staneja1/PI_wt_hold_for_laser_intensity_lock/README.md

# PI with integrator hold for intensity lock
