staneja1/PI_wt_hold_for_laser_intensity_lock/Full PI Board/kicad/3590p-2.stp

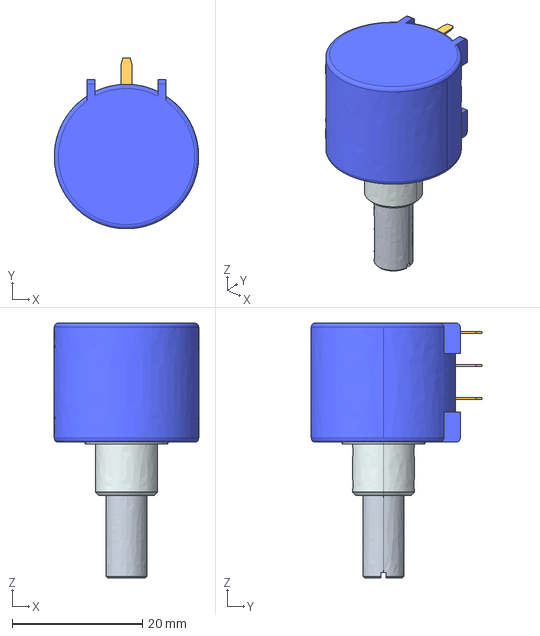
[picture p1: CAD file, 2025-07-23]
Full PI Board/kicad/3590p-2.stp
22.2 x 26.2 x 39.2 mm
