staneja1/PI_wt_hold_for_laser_intensity_lock/Test Board/Test Board/100SPxT2B4M7xE.stp

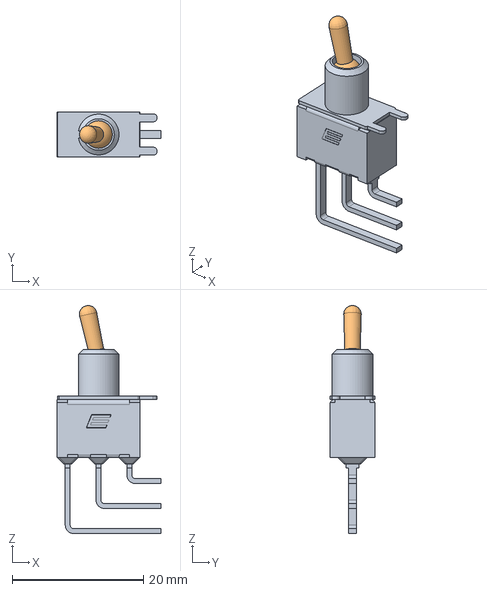
[picture p2: CAD file, 2025-07-23]
Test Board/Test Board/100SPxT2B4M7xE.stp
15.9 x 6.86 x 34.7 mm
