staneja1/PI_wt_hold_for_laser_intensity_lock/Full PI Board/kicad/141_100SPxT2B4M6xE.stp

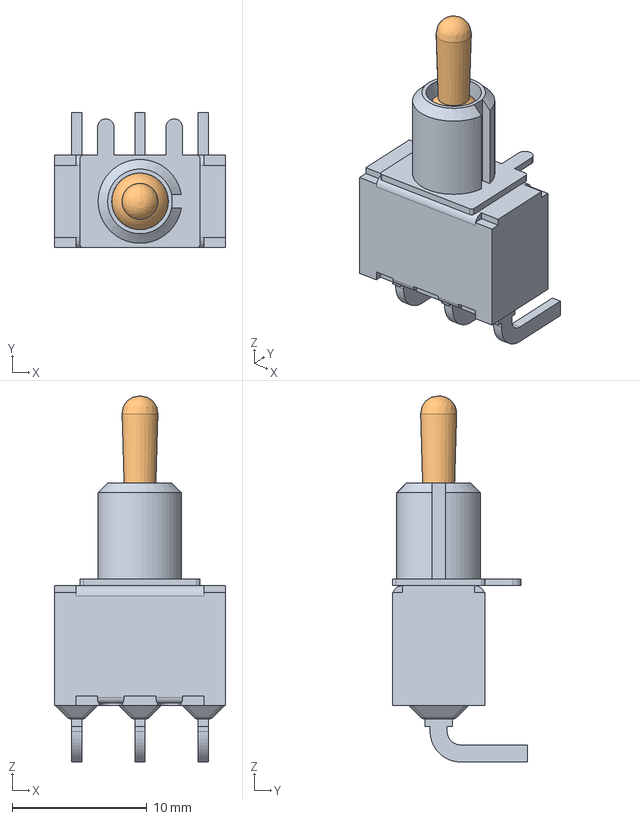
[picture p3: CAD file, 2025-07-23]
Full PI Board/kicad/141_100SPxT2B4M6xE.stp
12.7 x 10.0 x 27.2 mm
