staneja1/PI_wt_hold_for_laser_intensity_lock/Test Board/Test Board/Test Board.kicad_pcb

## KiCad design Test Board/Test Board/Test Board.kicad_pcb (2026-08-11)

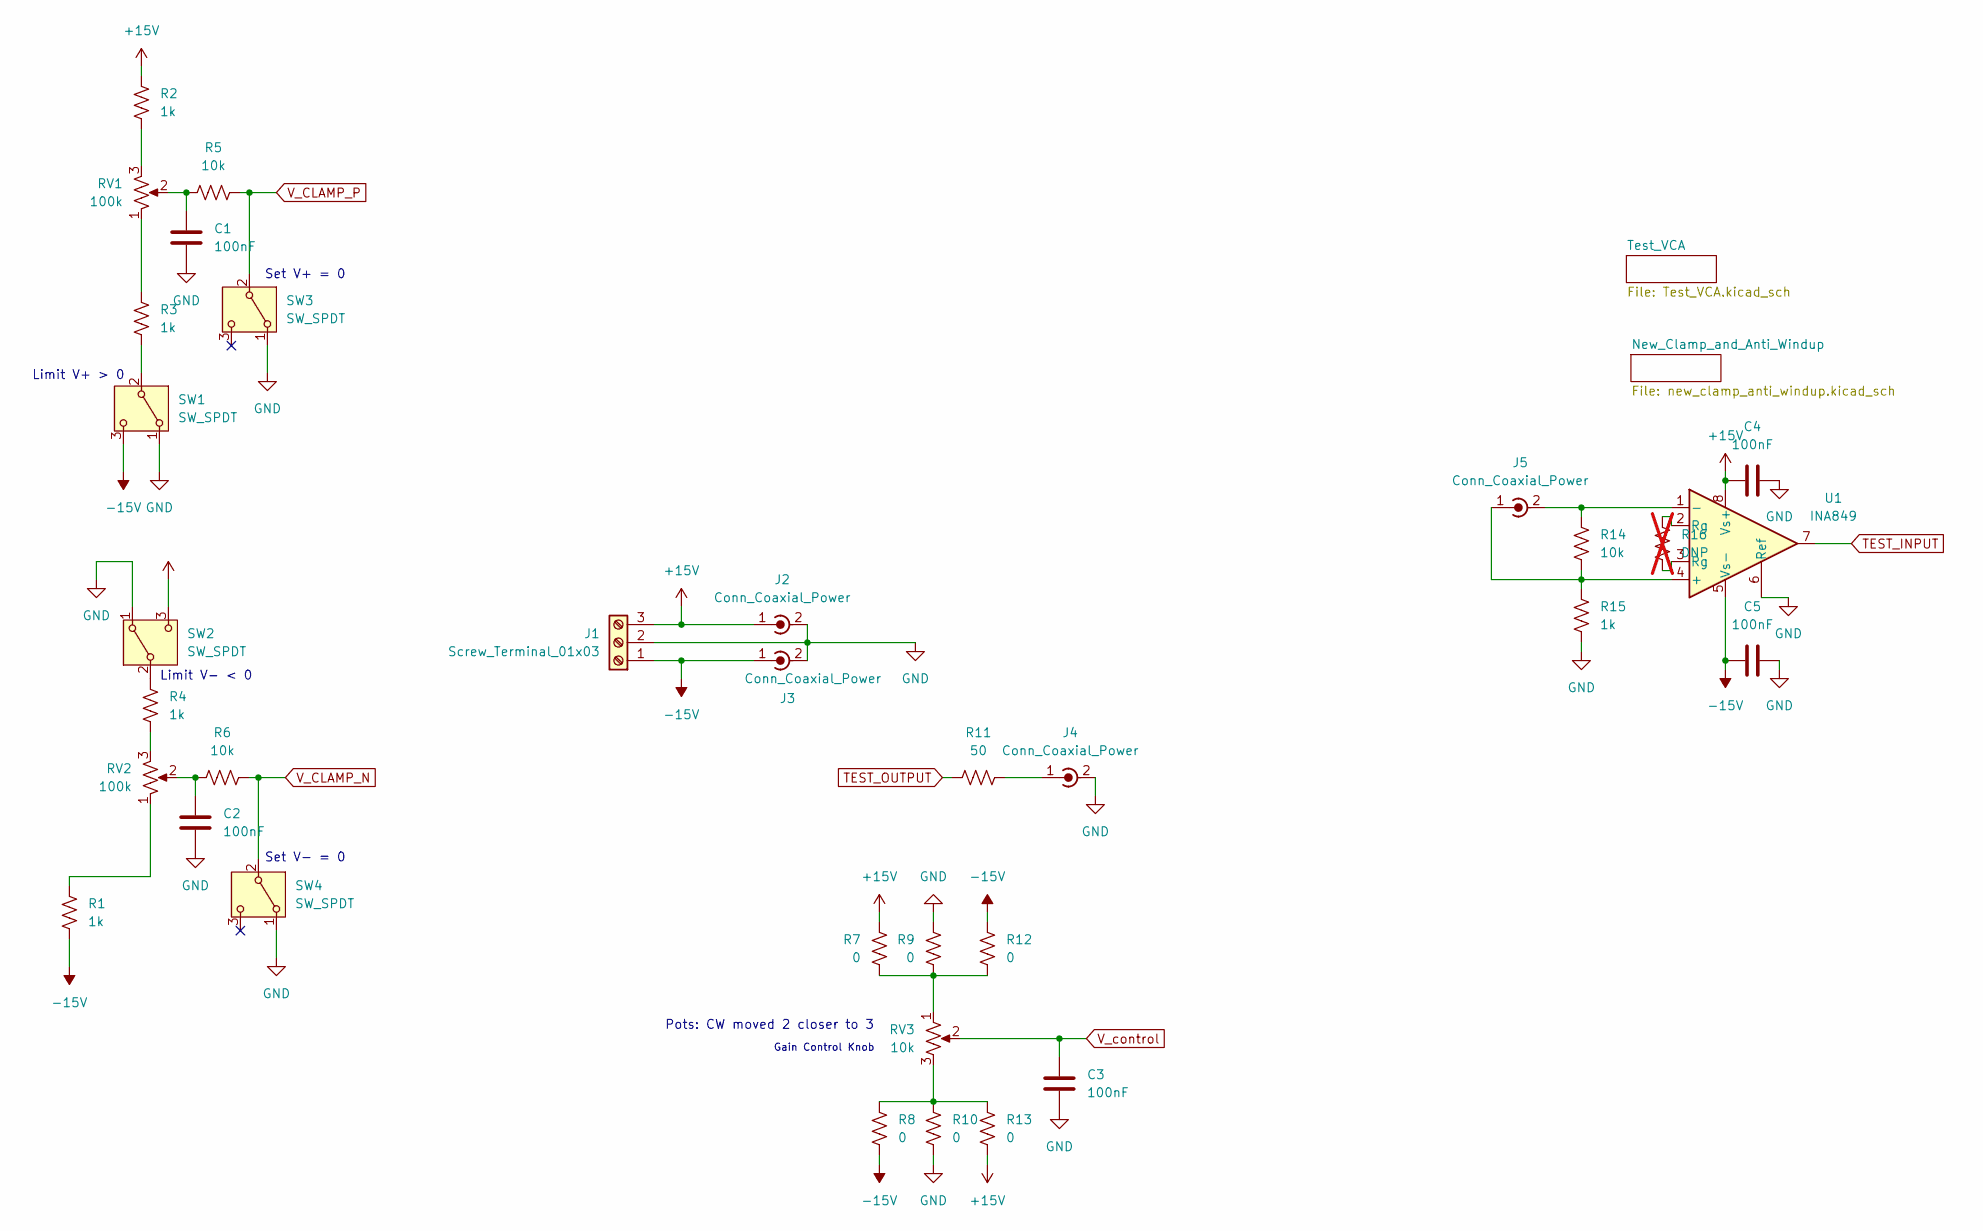
[picture p4: schematic Test Board.kicad_sch]

Parts:
C1, C2, C3, C4, C5: 100nF; C_0805_2012Metric; PARTNO CL21B104KCFNNNE; DIGIKEY 1276-6840-1-ND
J1: Screw_Terminal_01x03; TerminalBlock_4Ucon_1x03_P3.50mm_Horizontal; PARTNO 691214110003; DIGIKEY 732-2748-ND
J2, J3, J4, J5: Conn_Coaxial_Power; SMA_Amphenol_901-143_Horizontal
R1, R2, R3, R4: 1k; R_0805_2012Metric
R5, R6, R14: 10k; R_0805_2012Metric; PARTNO RN73H2ATTD1002B25; DIGIKEY 2019-RN73H2ATTD1002B25CT-ND
R7, R8, R9, R10, R12, R13: 0; R_0805_2012Metric; PARTNO CRCW080550R0FKTA; DIGIKEY 541-CRCW080550R0FKTACT-ND
R11: 50; R_0805_2012Metric; PARTNO CRCW080550R0FKTA; DIGIKEY 541-CRCW080550R0FKTACT-ND
R15: 1k; R_0805_2012Metric; PARTNO RG2012P-102-B-T5; DIGIKEY RG20P1.0KBCT-ND
R16: DNP; R_0805_2012Metric; not fitted
RV1, RV2: 100k; Potentiometer_Bourns_3296W_Vertical; PARTNO PV36W104C01B00; DIGIKEY 118-PV36W104C01B00-ND
RV3: 10k; Bourns Circular Pots; PARTNO 3590P-2-104L; DIGIKEY 3590P-2-104L-ND
SW1, SW2, SW3, SW4: SW_SPDT; TDD DIP Switch; PARTNO TDD01H0SB1R; DIGIKEY CKN10546CT-ND
U1: INA849; SOIC-8_3.9x4.9mm_P1.27mm; PARTNO INA849DR; DIGIKEY 296-INA849DRCT-ND

Connections:
+15V: C4.1, J1.3, J2.1 (In), R2.2, R7.2, R13.2, SW2.3 (C), U1.8 (Vs+); also elsewhere on the board
-15V: C5.1, J1.1, J3.1 (In), R1.1, R8.2, R12.2, SW1.3 (C), U1.5 (Vs-); also elsewhere on the board
GND: C1.1, C2.1, C3.1, C4.2, C5.2, J1.2, J2.2 (Ext), J3.2 (Ext), J4.2 (Ext), R9.2, R10.2, R15.1, SW1.1 (A), SW2.1 (A), SW3.1 (A), SW4.1 (A), U1.6 (Ref); also elsewhere on the board
unnamed: C1.2, R5.1, RV1.2
unnamed: C2.2, R6.1, RV2.2
unnamed: J4.1 (In), R11.2
unnamed: J5.2 (Ext), R14.2, U1.1 (-)
unnamed: J5.1 (In), R14.1, R15.2, U1.4 (+)
unnamed: R1.2, RV2.1
unnamed: R2.1, RV1.3
unnamed: R3.2, RV1.1
unnamed: R4.1, RV2.3
unnamed: R8.1, R10.1, R13.1, RV3.3
unnamed: R7.1, R9.1, R12.1, RV3.1
unnamed: R16.1, U1.3 (Rg)
unnamed: R16.2, U1.2 (Rg)
unnamed: R3.1, SW1.2 (B)
unnamed: R4.2, SW2.2 (B)
TEST_INPUT: U1.7; also elsewhere on the board
TEST_OUTPUT: R11.1; also elsewhere on the board
V_CLAMP_N: R6.2, SW4.2 (B); also elsewhere on the board
V_CLAMP_P: R5.2, SW3.2 (B); also elsewhere on the board
V_control: C3.2, RV3.2; also elsewhere on the board

Notes on the sheet:
Limit V+ > 0
Set V+ = 0
Limit V- < 0
Gain Control Knob
Set V- = 0
Pots: CW moved 2 closer to 3

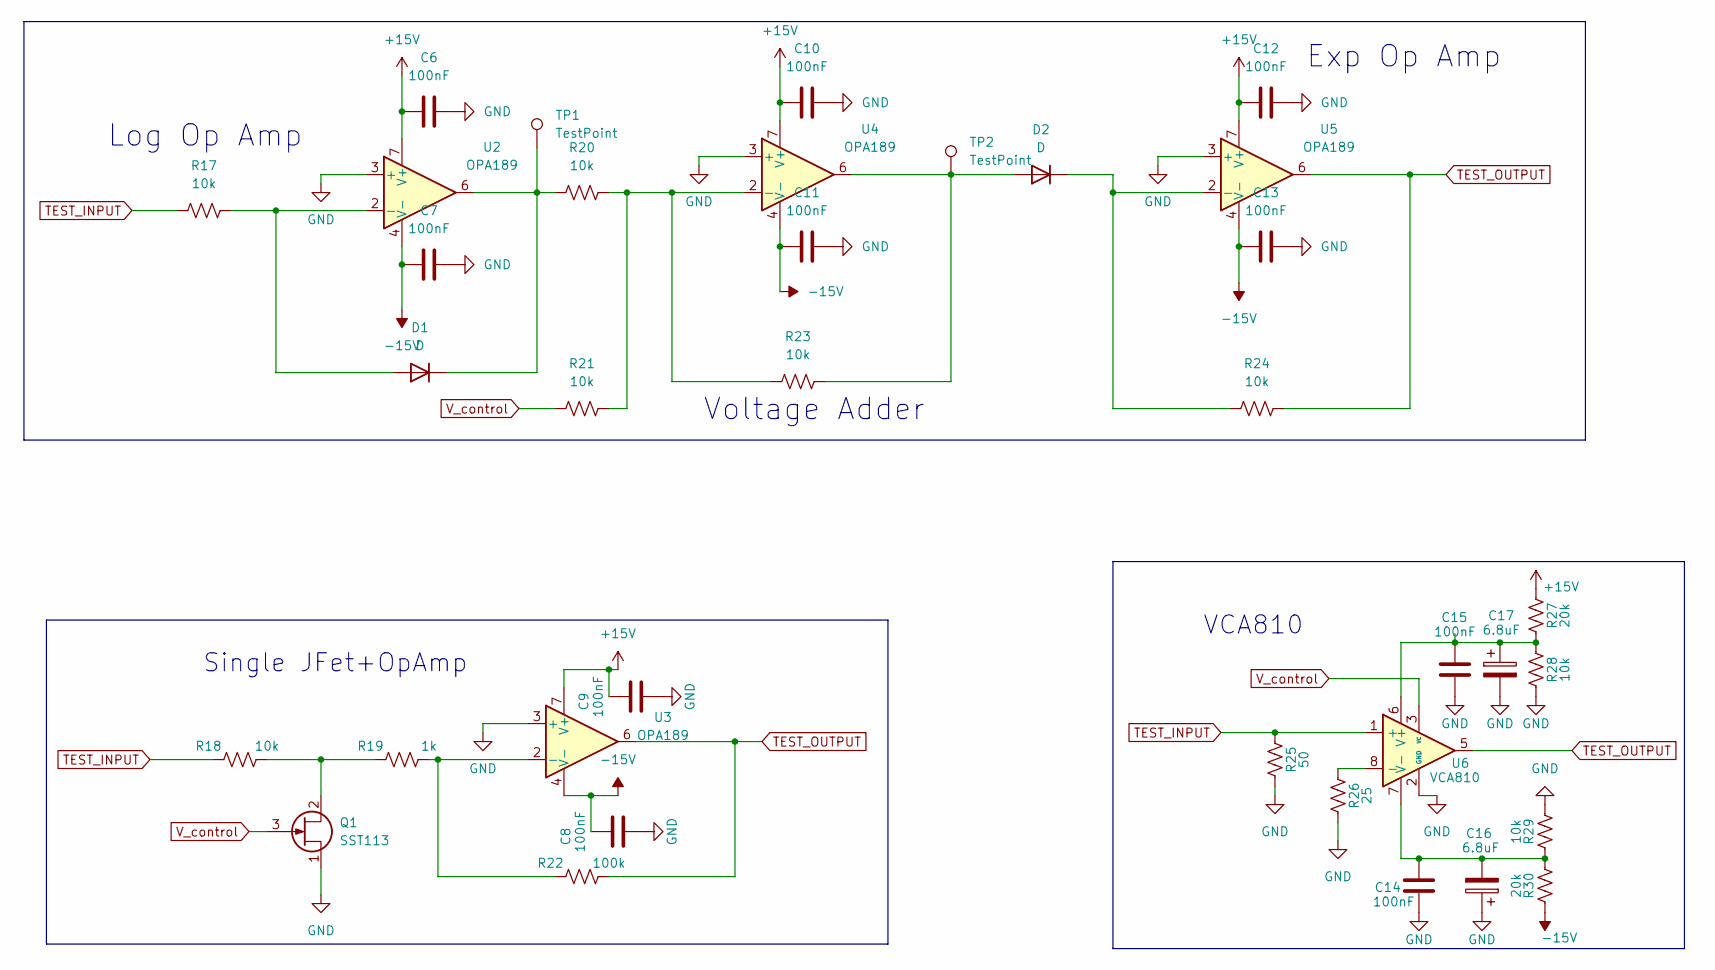
[picture p5: schematic Test_VCA.kicad_sch]

Parts:
C6, C7, C8, C9, C10, C11, C12, C13, C14, C15: 100nF; C_0805_2012Metric; PARTNO CL21B104KCFNNNE; DIGIKEY 1276-6840-1-ND
C16, C17: 6.8uF; C_0805_2012Metric
D1, D2: D; TSOT-23; PARTNO SSTPAD5 SOT-23 3L ROHS; DIGIKEY 4004-SSTPAD5SOT-233LROHSCT-ND
Q1: SST113; SOT-23
R17, R18, R23, R24, R28, R29: 10k; R_0805_2012Metric
R19: 1k; R_0805_2012Metric
R20, R21: 10k; R_0805_2012Metric; PARTNO RN73H2ATTD1002B25; DIGIKEY 2019-RN73H2ATTD1002B25CT-ND
R22: 100k; R_0805_2012Metric
R25: 50; R_0805_2012Metric
R26: 25; R_0805_2012Metric
R27, R30: 20k; R_0805_2012Metric
TP1, TP2: TestPoint; TestPoint_Loop_D2.60mm_Drill1.6mm_Beaded
U2, U3, U4, U5: OPA189; SOIC-8_3.9x4.9mm_P1.27mm; PARTNO OPA189ID; DIGIKEY 296-47522-ND
U6: VCA810; SOIC-8_3.9x4.9mm_P1.27mm

Connections:
+15V: C6.1, C9.1, C10.1, C12.1, R27.1, U2.7 (V+), U3.7 (V+), U4.7 (V+), U5.7 (V+); also elsewhere on the board
-15V: C7.1, C8.1, C11.1, C13.1, R30.1, U2.4 (V-), U3.4 (V-), U4.4 (V-), U5.4 (V-); also elsewhere on the board
GND: C6.2, C7.2, C8.2, C9.2, C10.2, C11.2, C12.2, C13.2, C14.2, C15.2, C16.1, C17.2, Q1.1 (S), R25.2, R26.2, R28.2, R29.2, U2.3 (+), U3.3 (+), U4.3 (+), U5.3 (+), U6.2 (GND); also elsewhere on the board
unnamed: D1.2 (A), R17.2, U2.2 (-)
unnamed: D1.1 (K), R20.1, TP1.1 (1_1), U2.6
unnamed: D2.2 (A), R23.2, TP2.1 (1_1), U4.6
unnamed: D2.1 (K), R24.1, U5.2 (-)
unnamed: Q1.2 (D), R18.2, R19.1
unnamed: R19.2, R22.1, U3.2 (-)
unnamed: R20.2, R21.2, R23.1, U4.2 (-)
unnamed: R26.1, U6.8 (-)
unnamed: C15.1, C17.1, R27.2, R28.1, U6.6 (V+)
unnamed: C14.1, C16.2, R29.1, R30.2, U6.7 (V-)
TEST_INPUT: R17.1, R18.1, R25.1, U6.1 (+); also elsewhere on the board
TEST_OUTPUT: R22.2, R24.2, U3.6, U5.6, U6.5; also elsewhere on the board
V_control: Q1.3 (G), R21.1, U6.3 (VC); also elsewhere on the board

Notes on the sheet:
Exp Op Amp
Voltage Adder
Single JFet+OpAmp
VCA810
Log Op Amp

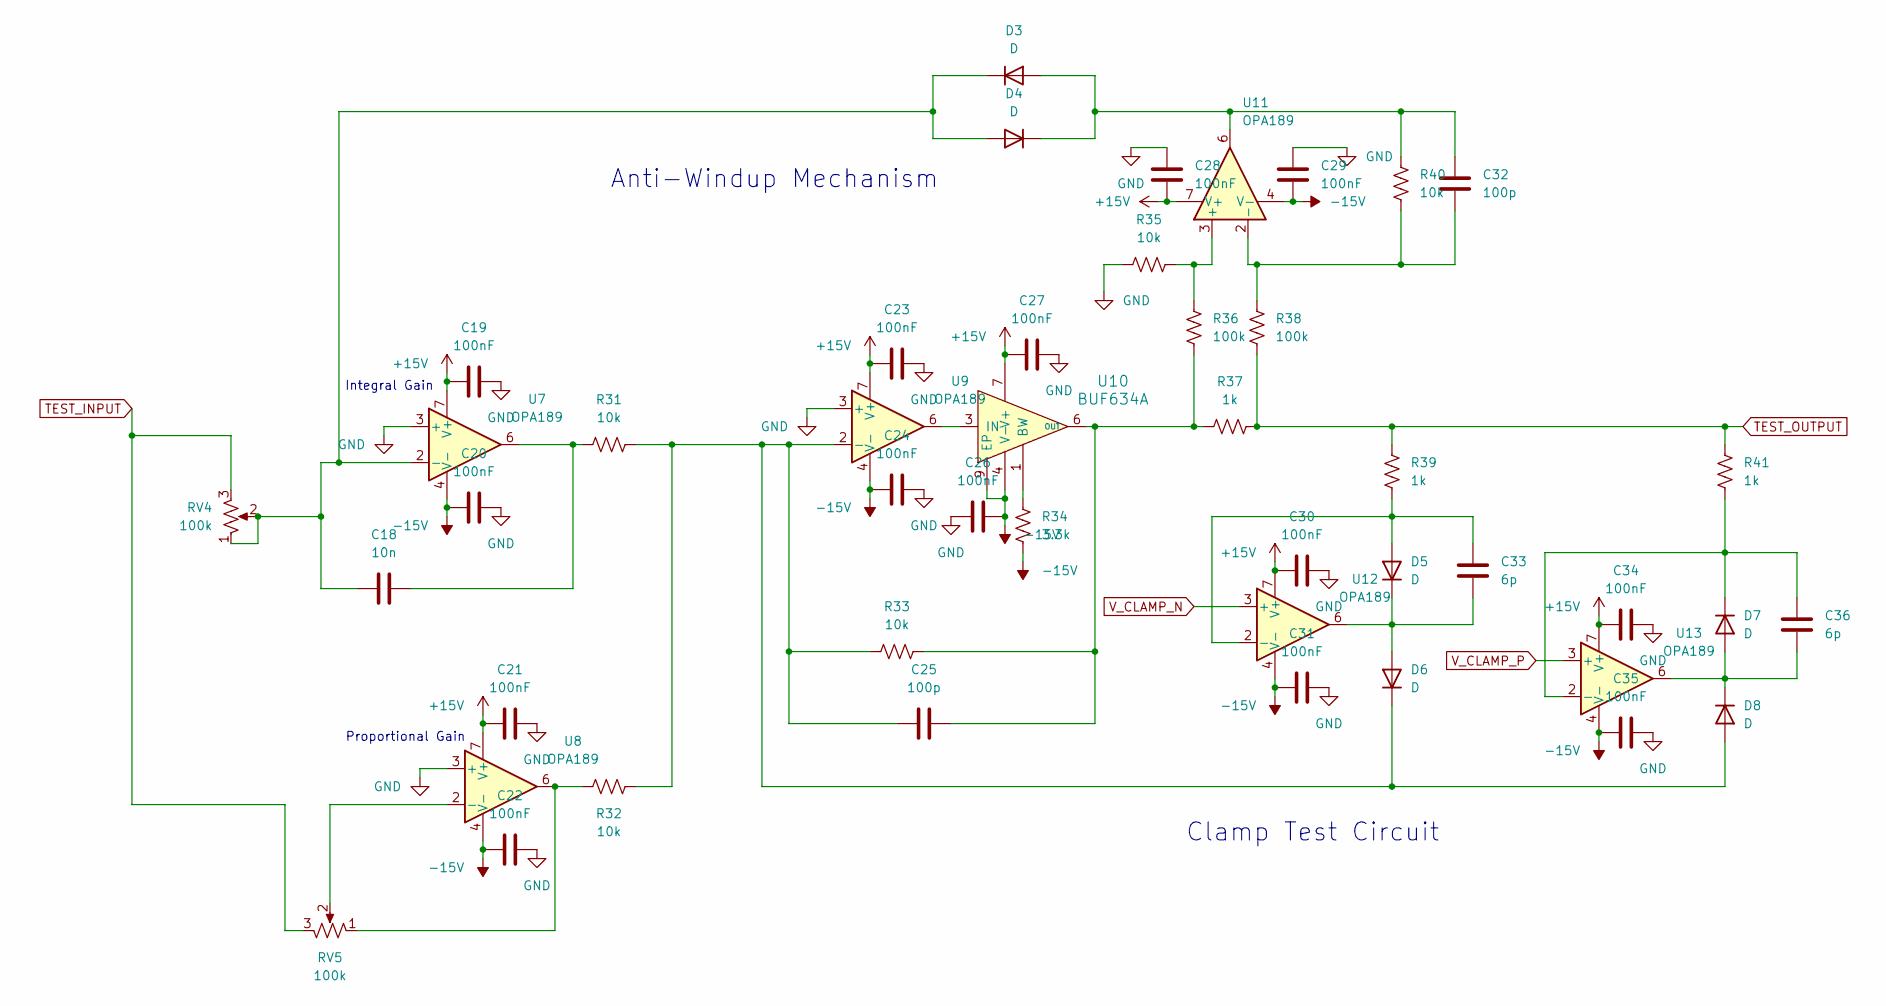
[picture p6: schematic new_clamp_anti_windup.kicad_sch]

Parts:
C18: 10n; C_0805_2012Metric; PARTNO C0805C101J5GACTU; DIGIKEY 399-C0805C101J5GACTUCT-ND
C19, C20, C21, C22, C23, C24, C26, C27, C28, C29, C30, C31, C34, C35: 100nF; C_0805_2012Metric; PARTNO CL21B104KCFNNNE; DIGIKEY 1276-6840-1-ND
C25, C32: 100p; C_0805_2012Metric; PARTNO C0805C101J5GACTU; DIGIKEY 399-C0805C101J5GACTUCT-ND
C33, C36: 6p; C_0805_2012Metric
D3, D4, D5, D6, D7, D8: D; TSOT-23; PARTNO SSTPAD5 SOT-23 3L ROHS; DIGIKEY 4004-SSTPAD5SOT-233LROHSCT-ND
R31, R32, R33, R35, R40: 10k; R_0805_2012Metric; PARTNO RN73H2ATTD1002B25; DIGIKEY 2019-RN73H2ATTD1002B25CT-ND
R34: 3.3k; R_0805_2012Metric; PARTNO RC0805FR-073K3L; DIGIKEY 311-3.30KCRCT-ND
R36, R38: 100k; R_0805_2012Metric; PARTNO RN73H2ATTD1002B25; DIGIKEY 2019-RN73H2ATTD1002B25CT-ND
R37, R39, R41: 1k; R_0805_2012Metric; PARTNO RG2012P-102-B-T5; DIGIKEY RG20P1.0KBCT-ND
RV4, RV5: 100k; Potentiometer_Bourns_3296W_Vertical; PARTNO PV36W104C01B00; DIGIKEY 118-PV36W104C01B00-ND
U7, U8, U9, U11, U12, U13: OPA189; SOIC-8_3.9x4.9mm_P1.27mm; PARTNO OPA189ID; DIGIKEY 296-47522-ND
U10: BUF634A; BUF634AIDDAR; PARTNO BUF634AIDDAR; DIGIKEY 296-BUF634AIDDARCT-ND

Connections:
+15V: C19.1, C21.1, C23.1, C27.1, C28.2, C30.1, C34.1, U7.7 (V+), U8.7 (V+), U9.7 (V+), U10.7 (V+), U11.7 (V+), U12.7 (V+), U13.7 (V+); also elsewhere on the board
-15V: C20.1, C22.1, C24.1, C26.2, C29.1, C31.1, C35.1, R34.1, U7.4 (V-), U8.4 (V-), U9.4 (V-), U10.4 (V-), U10.9 (EP), U11.4 (V-), U12.4 (V-), U13.4 (V-); also elsewhere on the board
GND: C19.2, C20.2, C21.2, C22.2, C23.2, C24.2, C26.1, C27.2, C28.1, C29.2, C30.2, C31.2, C34.2, C35.2, R35.2, U7.3 (+), U8.3 (+), U9.3 (+); also elsewhere on the board
unnamed: C18.1, R31.1, U7.6
unnamed: C32.1, D3.2 (A), D4.1 (K), R40.2, U11.6
unnamed: C18.2, D3.1 (K), D4.2 (A), RV4.1, RV4.2, U7.2 (-)
unnamed: C33.1, D5.2 (A), R39.1, U12.2 (-)
unnamed: C33.2, D5.1 (K), D6.2 (A), U12.6
unnamed: C25.2, D6.1 (K), D8.2 (A), R31.2, R32.2, R33.1, U9.2 (-)
unnamed: C36.2, D7.2 (A), D8.1 (K), U13.6
unnamed: C36.1, D7.1 (K), R41.1, U13.2 (-)
unnamed: R32.1, RV5.1, U8.6
unnamed: RV5.2, U8.2 (-)
unnamed: R34.2, U10.1 (BW)
unnamed: U9.6, U10.3 (IN)
unnamed: C25.1, R33.2, R36.1, R37.2, U10.6 (OUT)
unnamed: R35.1, R36.2, U11.3 (+)
unnamed: C32.2, R38.2, R40.1, U11.2 (-)
TEST_INPUT: RV4.3, RV5.3; also elsewhere on the board
TEST_OUTPUT: R37.1, R38.1, R39.2, R41.2; also elsewhere on the board
V_CLAMP_N: U12.3 (+); also elsewhere on the board
V_CLAMP_P: U13.3 (+); also elsewhere on the board

Notes on the sheet:
Clamp Test Circuit
Proportional Gain
Anti-Windup Mechanism
Integral Gain

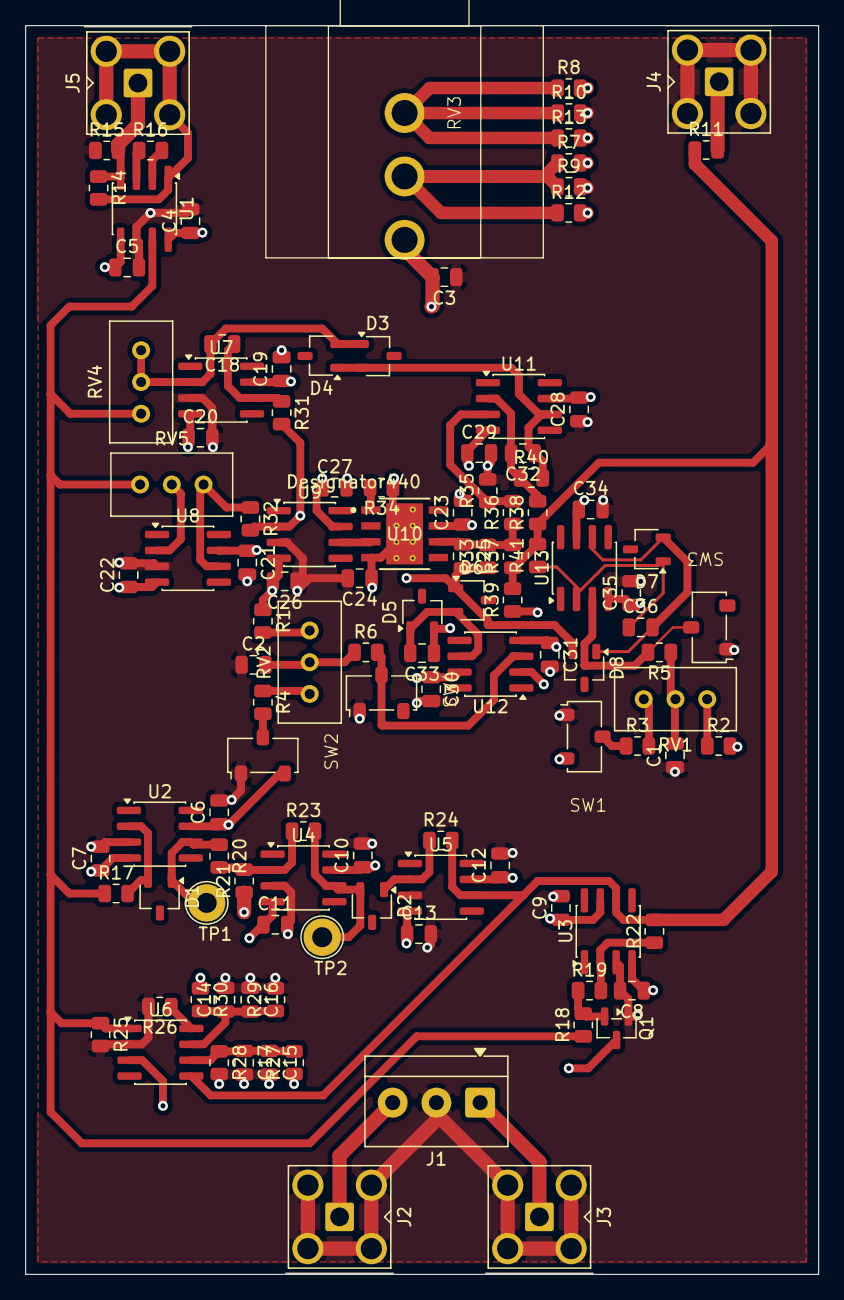
[picture p7: board Test Board.kicad_pcb from above]

Board: 4 copper layers, 63.5 x 100.0 mm, 115 parts (0 on the bottom side), 48 nets.
