staneja1/PI_wt_hold_for_laser_intensity_lock/Full PI Board/kicad/intensity_pi.kicad_pcb

## KiCad design Full PI Board/kicad/intensity_pi.kicad_pcb (2026-08-06)

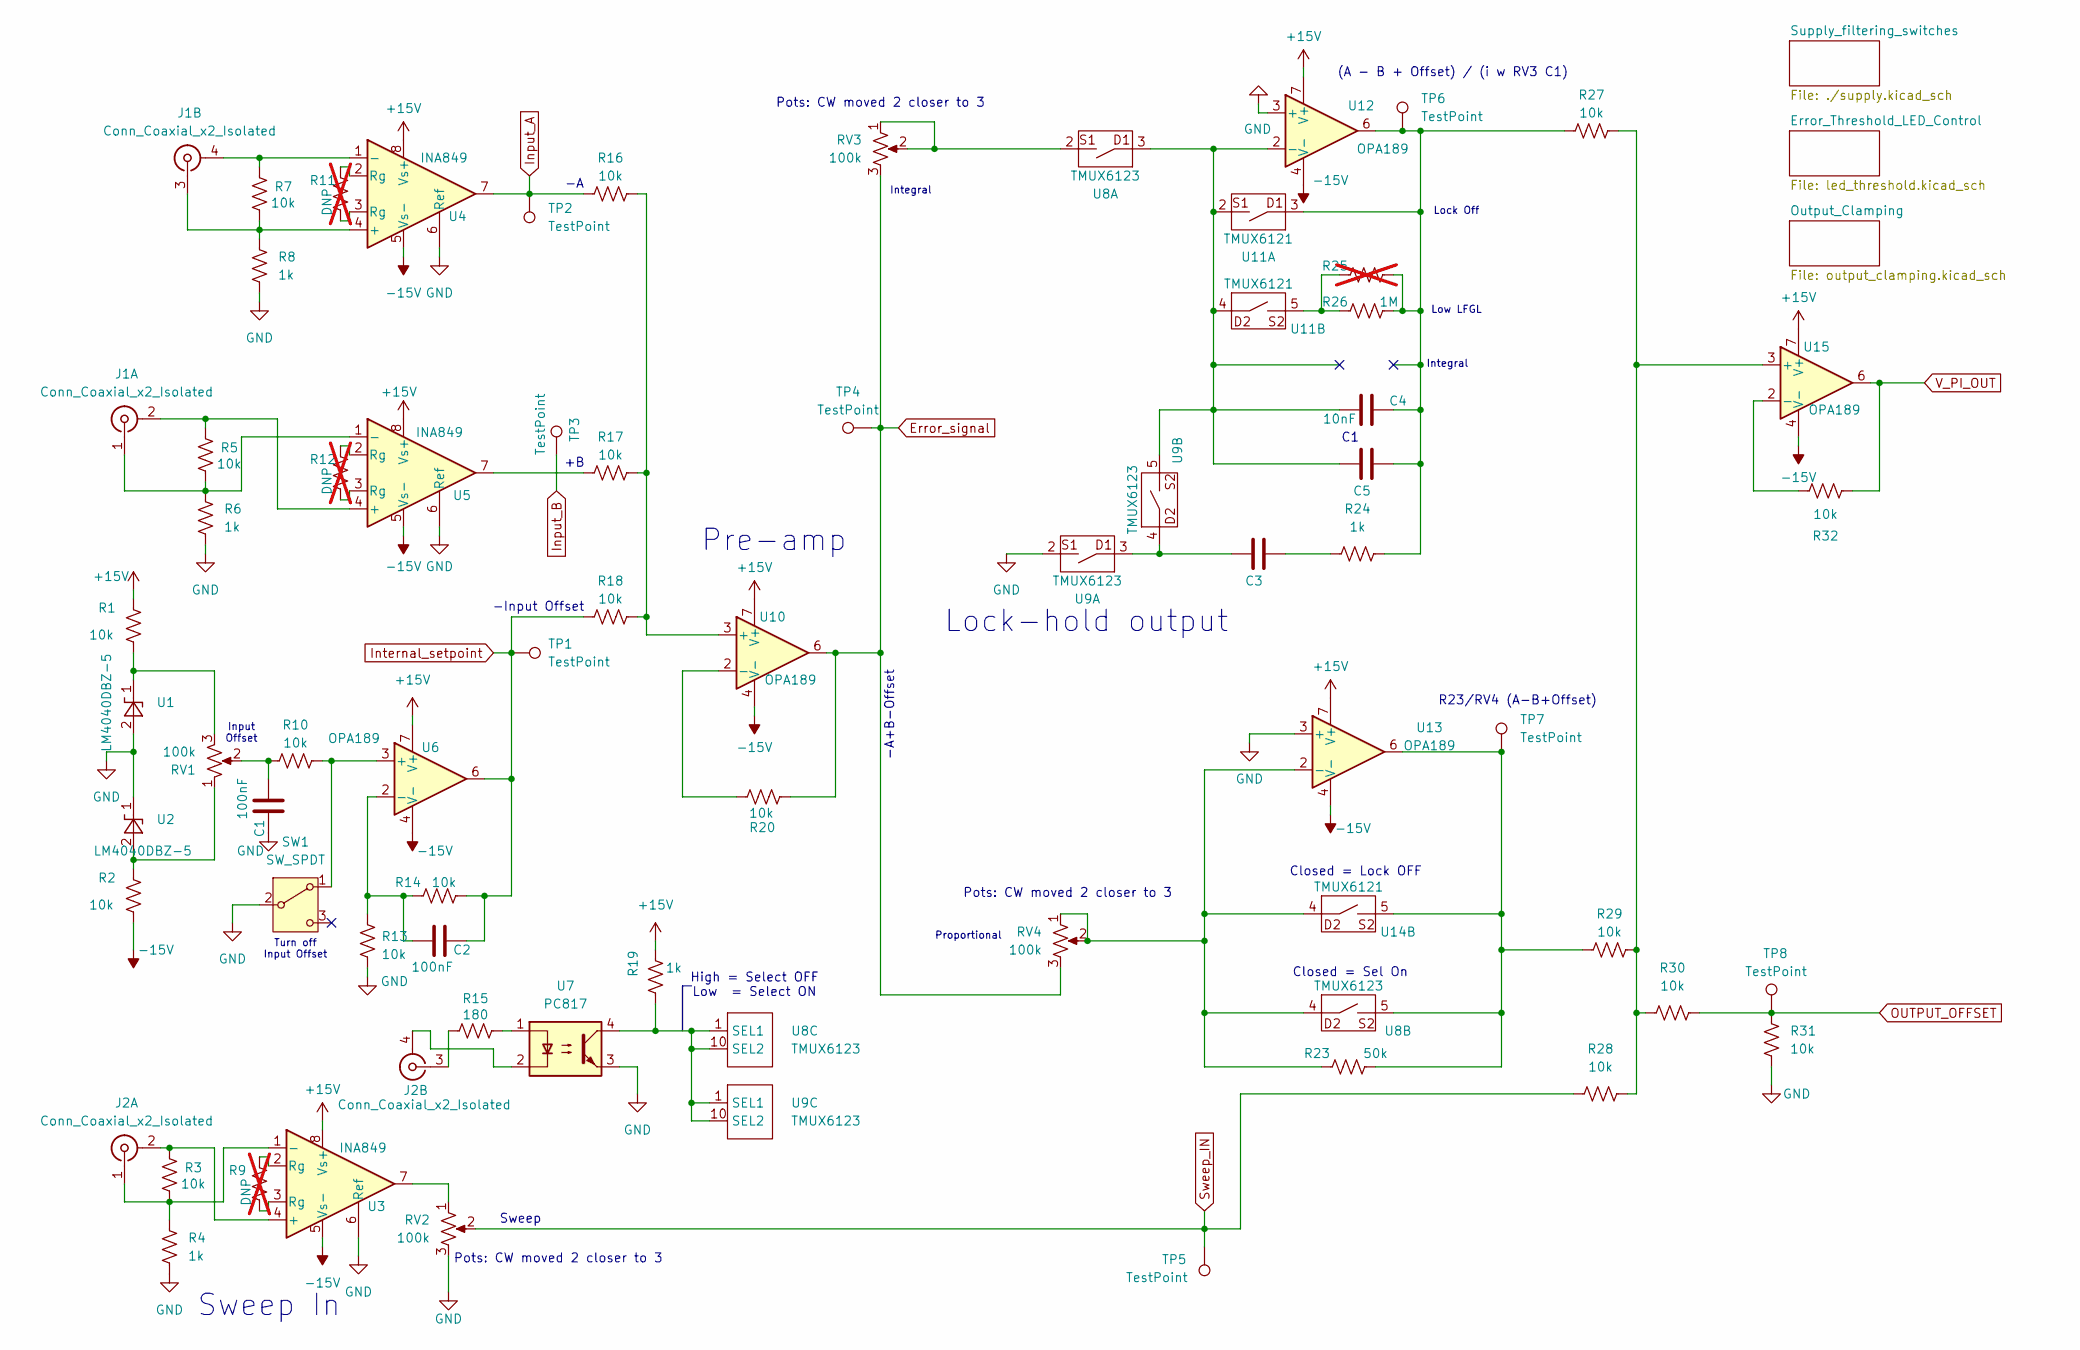
[picture p8: schematic intensity_pi.kicad_sch]

Parts:
C1, C2: 100nF; C_0805_2012Metric; PARTNO CL21B104KCFNNNE; DIGIKEY 1276-6840-1-ND
C3: C; C_0805_2012Metric
C4: 10nF; C_0805_2012Metric; PARTNO C0805C103K5RACTU; DIGIKEY 399-C0805C103K5RACTUCT-ND
C5: C; C_Axial_L3.8mm_D2.6mm_P7.50mm_Horizontal
J1, J2: Conn_Coaxial_x2_Isolated; BNC_Amphenol_031-6575_Horizontal; PARTNO 031-6575; DIGIKEY ARF2111-ND
R1, R2, R3, R5, R7, R10, R13, R14, R16, R17, R18, R27, R28, R29, R30, R31, R32: 10k; R_0805_2012Metric; PARTNO RN73H2ATTD1002B25; DIGIKEY 2019-RN73H2ATTD1002B25CT-ND
R4, R6, R8, R19, R24: 1k; R_0805_2012Metric; PARTNO RG2012P-102-B-T5; DIGIKEY RG20P1.0KBCT-ND
R9, R11, R12: DNP; R_0805_2012Metric; not fitted
R15: 180; R_0805_2012Metric; PARTNO CR0805-FX-1800ELF; DIGIKEY CR0805-FX-1800ELFCT-ND
R20: 10k; R_0805_2012Metric; PARTNO CRG0805F11K; DIGIKEY A126334CT-ND
R23: 50k; R_0805_2012Metric
R25: R_Axial_DIN0204_L3.6mm_D1.6mm_P7.62mm_Horizontal; not fitted
R26: 1M; R_0805_2012Metric; PARTNO AC0805JR-071ML; DIGIKEY YAG3766CT-ND
RV1, RV2, RV3, RV4: 100k; Bourns Circular Pots; PARTNO 3590P-2-104L; DIGIKEY 3590P-2-104L-ND
SW1: SW_SPDT; Right Angle SPDT Vertical; PARTNO 100SP1T1B1M7QEH; DIGIKEY 100SP1T1B1M7QEH-ND
TP1, TP2, TP3, TP4, TP5, TP6, TP7, TP8: TestPoint; TestPoint_Loop_D2.60mm_Drill1.6mm_Beaded
U1, U2: LM4040DBZ-5; SOT-23; PARTNO LM4040B50FTA; DIGIKEY LM4040B50FTADICT-ND
U3, U4, U5: INA849; SOIC-8_3.9x4.9mm_P1.27mm; PARTNO INA849DR; DIGIKEY 296-INA849DRCT-ND
U6, U10, U12, U13, U15: OPA189; SOIC-8_3.9x4.9mm_P1.27mm; PARTNO OPA189ID; DIGIKEY 296-47522-ND
U7: PC817; DIP-4_W7.62mm; PARTNO ISP817A; DIGIKEY ISP817A
U8, U9: TMUX6123; PARTNO TMUX6123DGSR; DIGIKEY 296-53449-1-ND
U11, U14: TMUX6121; PARTNO TMUX6123DGSR; DIGIKEY 296-53449-1-ND

Connections:
+15V: R1.2, R19.1, U3.8 (Vs+), U4.8 (Vs+), U5.8 (Vs+), U6.7 (V+), U10.7 (V+), U12.7 (V+), U13.7 (V+), U15.7 (V+); also elsewhere on the board
-15V: R2.1, U3.5 (Vs-), U4.5 (Vs-), U5.5 (Vs-), U6.4 (V-), U10.4 (V-), U12.4 (V-), U13.4 (V-), U15.4 (V-); also elsewhere on the board
Error_signal: R20.1, RV3.3, RV4.3, TP4.1 (1_1), U10.6; also elsewhere on the board
GND: C1.1, R4.1, R6.1, R8.1, R13.1, R31.2, RV2.3, SW1.2 (B), U1.2 (A), U2.1 (K), U3.6 (Ref), U4.6 (Ref), U5.6 (Ref), U7.3, U9.2, U12.3 (+), U13.3 (+); also elsewhere on the board
Input_A: R16.1, TP2.1 (1_1), U4.7
Input_B: TP3.1 (1_1)
Internal_setpoint: C2.1, R14.2, R18.1, TP1.1 (1_1), U6.6
unnamed: C1.2, R10.1, RV1.2
unnamed: C3.1, U9.3, U9.4
unnamed: C3.2, R24.2
unnamed: J1.2 (Ext1), R5.2, U5.4 (+)
unnamed: J1.1 (In1), R5.1, R6.2, U5.1 (-)
unnamed: J1.4 (Ext2), R7.2, U4.1 (-)
unnamed: J1.3 (In2), R7.1, R8.2, U4.4 (+)
unnamed: J2.2 (Ext1), R3.2, U3.4 (+)
unnamed: J2.1 (In1), R3.1, R4.2, U3.1 (-)
unnamed: J2.4 (Ext2), U7.2
unnamed: J2.3 (In2), R15.2
unnamed: R9.1, U3.3 (Rg)
unnamed: R9.2, U3.2 (Rg)
unnamed: R11.1, U4.3 (Rg)
unnamed: R11.2, U4.2 (Rg)
unnamed: R12.1, U5.3 (Rg)
unnamed: R12.2, U5.2 (Rg)
unnamed: R15.1, U7.1
unnamed: R17.1, U5.7
unnamed: R23.2, R29.1, TP7.1 (1_1), U8.5, U13.6, U14.5
unnamed: R25.1, R26.1, U11.5
unnamed: RV2.1, U3.7
unnamed: RV3.1, RV3.2, U8.2
unnamed: R10.2, SW1.1 (A), U6.3 (+)
unnamed: R1.1, RV1.3, U1.1 (K)
unnamed: R2.2, RV1.1, U2.2 (A)
unnamed: C2.2, R13.2, R14.1, U6.2 (-)
unnamed: R19.2, U7.4, U8.1 (SEL1), U8.10 (SEL2), U9.1 (SEL1), U9.10 (SEL2)
unnamed: R16.2, R17.2, R18.2, U10.3 (+)
unnamed: R20.2, U10.2 (-)
unnamed: R23.1, RV4.1, RV4.2, U8.4, U13.2 (-), U14.4
unnamed: R27.2, R28.2, R29.2, R30.2, U15.3 (+)
unnamed: R32.2, U15.2 (-)
OUTPUT_OFFSET: R30.1, R31.1, TP8.1 (1_1); also elsewhere on the board
Sweep_IN: R28.1, RV2.2, TP5.1 (1_1)
V_PI_OUT: R32.1, U15.6; also elsewhere on the board

Notes on the sheet:
-Input Offset
Lock Off
High = Select OFF Low = Select ON
Input Offset
Pots: CW moved 2 closer to 3
Low LFGL
(A - B + Offset) / (i w RV3 C1)
Pre-amp
Closed = Lock OFF
-A+B-Offset
Sweep
Integral
Turn off Input Offset
Proportional
Closed = Sel On
R23/RV4 (A-B+Offset)
Sweep In
Lock-hold output

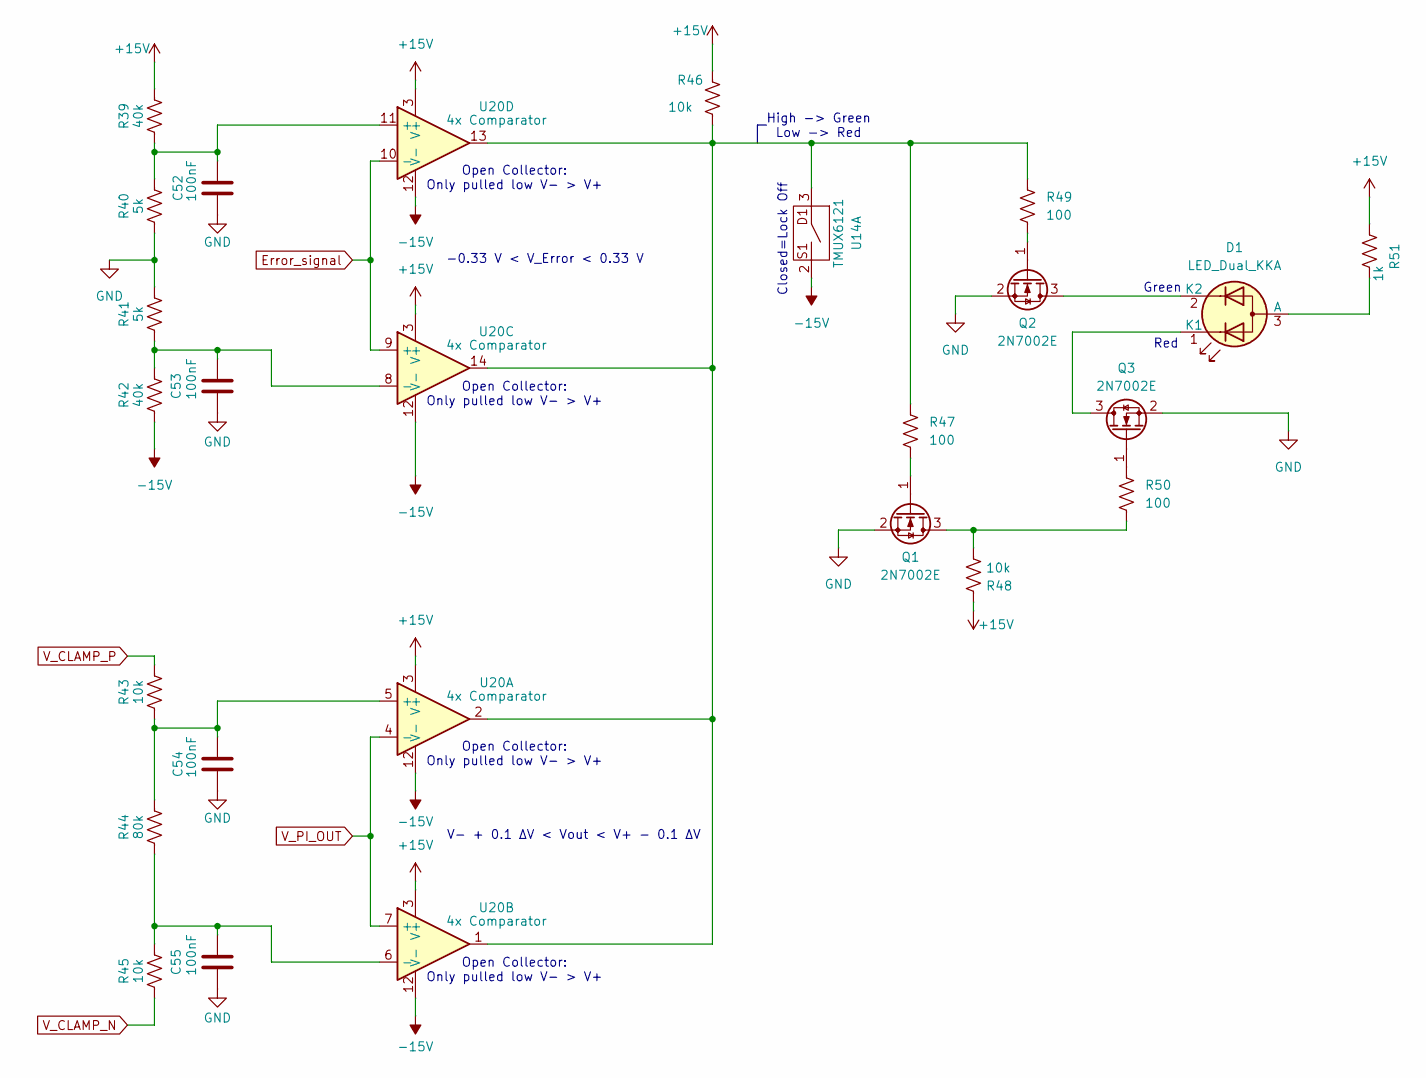
[picture p9: schematic led_threshold.kicad_sch]

Parts:
C52, C53, C54, C55: 100nF; C_0805_2012Metric; PARTNO CL21B104KCFNNNE; DIGIKEY 1276-6840-1-ND
D1: LED_Dual_KKA; GR LED; PARTNO LTST-S326KGJRKT; DIGIKEY 160-2033-1-ND
Q1, Q2, Q3: 2N7002E; SOT-23; PARTNO 2N7002BK,215; DIGIKEY 1727-4789-1-ND
R39, R42: 40k; R_0805_2012Metric
R40, R41: 5k; R_0805_2012Metric
R43, R45: 10k; R_0805_2012Metric
R44: 80k; R_0805_2012Metric
R46, R48: 10k; R_0805_2012Metric; PARTNO RN73H2ATTD1002B25; DIGIKEY 2019-RN73H2ATTD1002B25CT-ND
R47, R49, R50: 100; R_0805_2012Metric; PARTNO ERJ-P06F1000V; DIGIKEY P16057CT-ND
R51: 1k; R_0805_2012Metric; PARTNO RG2012P-102-B-T5; DIGIKEY RG20P1.0KBCT-ND
U14: TMUX6121; PARTNO TMUX6123DGSR; DIGIKEY 296-53449-1-ND
U20: 4x Comparator; SOIC-14; PARTNO UPC177G2(20)-E2-A; DIGIKEY 559-UPC177G2(20)-E2-ACT-ND

Connections:
+15V: R39.2, R46.2, R48.2, R51.1, U20.3 (V+); also elsewhere on the board
-15V: R42.1, U14.2, U20.12 (V-); also elsewhere on the board
Error_signal: U20.9 (+), U20.10 (-); also elsewhere on the board
GND: C52.1, C53.1, C54.1, C55.1, Q1.2 (S), Q2.2 (S), Q3.2 (S), R40.1, R41.2; also elsewhere on the board
unnamed: D1.3 (A), R51.2
unnamed: D1.1 (K1), Q3.3 (D)
unnamed: D1.2 (K2), Q2.3 (D)
unnamed: Q1.3 (D), R48.1, R50.2
unnamed: Q1.1 (G), R47.2
unnamed: Q2.1 (G), R49.2
unnamed: Q3.1 (G), R50.1
unnamed: R46.1, R47.1, R49.1, U14.3, U20.1, U20.2, U20.13, U20.14
unnamed: C54.2, R43.1, R44.2, U20.5 (+)
unnamed: C55.2, R44.1, R45.2, U20.6 (-)
unnamed: C53.2, R41.1, R42.2, U20.8 (-)
unnamed: C52.2, R39.1, R40.2, U20.11 (+)
V_CLAMP_N: R45.1; also elsewhere on the board
V_CLAMP_P: R43.2; also elsewhere on the board
V_PI_OUT: U20.4 (-), U20.7 (+); also elsewhere on the board

Notes on the sheet:
Open Collector: Only pulled low V- > V+
Red
V- + 0.1 ∆V < Vout < V+ - 0.1 ∆V
-0.33 V < V_Error < 0.33 V
Green
Closed=Lock Off
High -> Green Low -> Red
