staneja1/PI_wt_hold_for_laser_intensity_lock/Full PI Board/kicad/intensity_pi.kicad_pcb

## KiCad design Full PI Board/kicad/intensity_pi.kicad_pcb (continued)

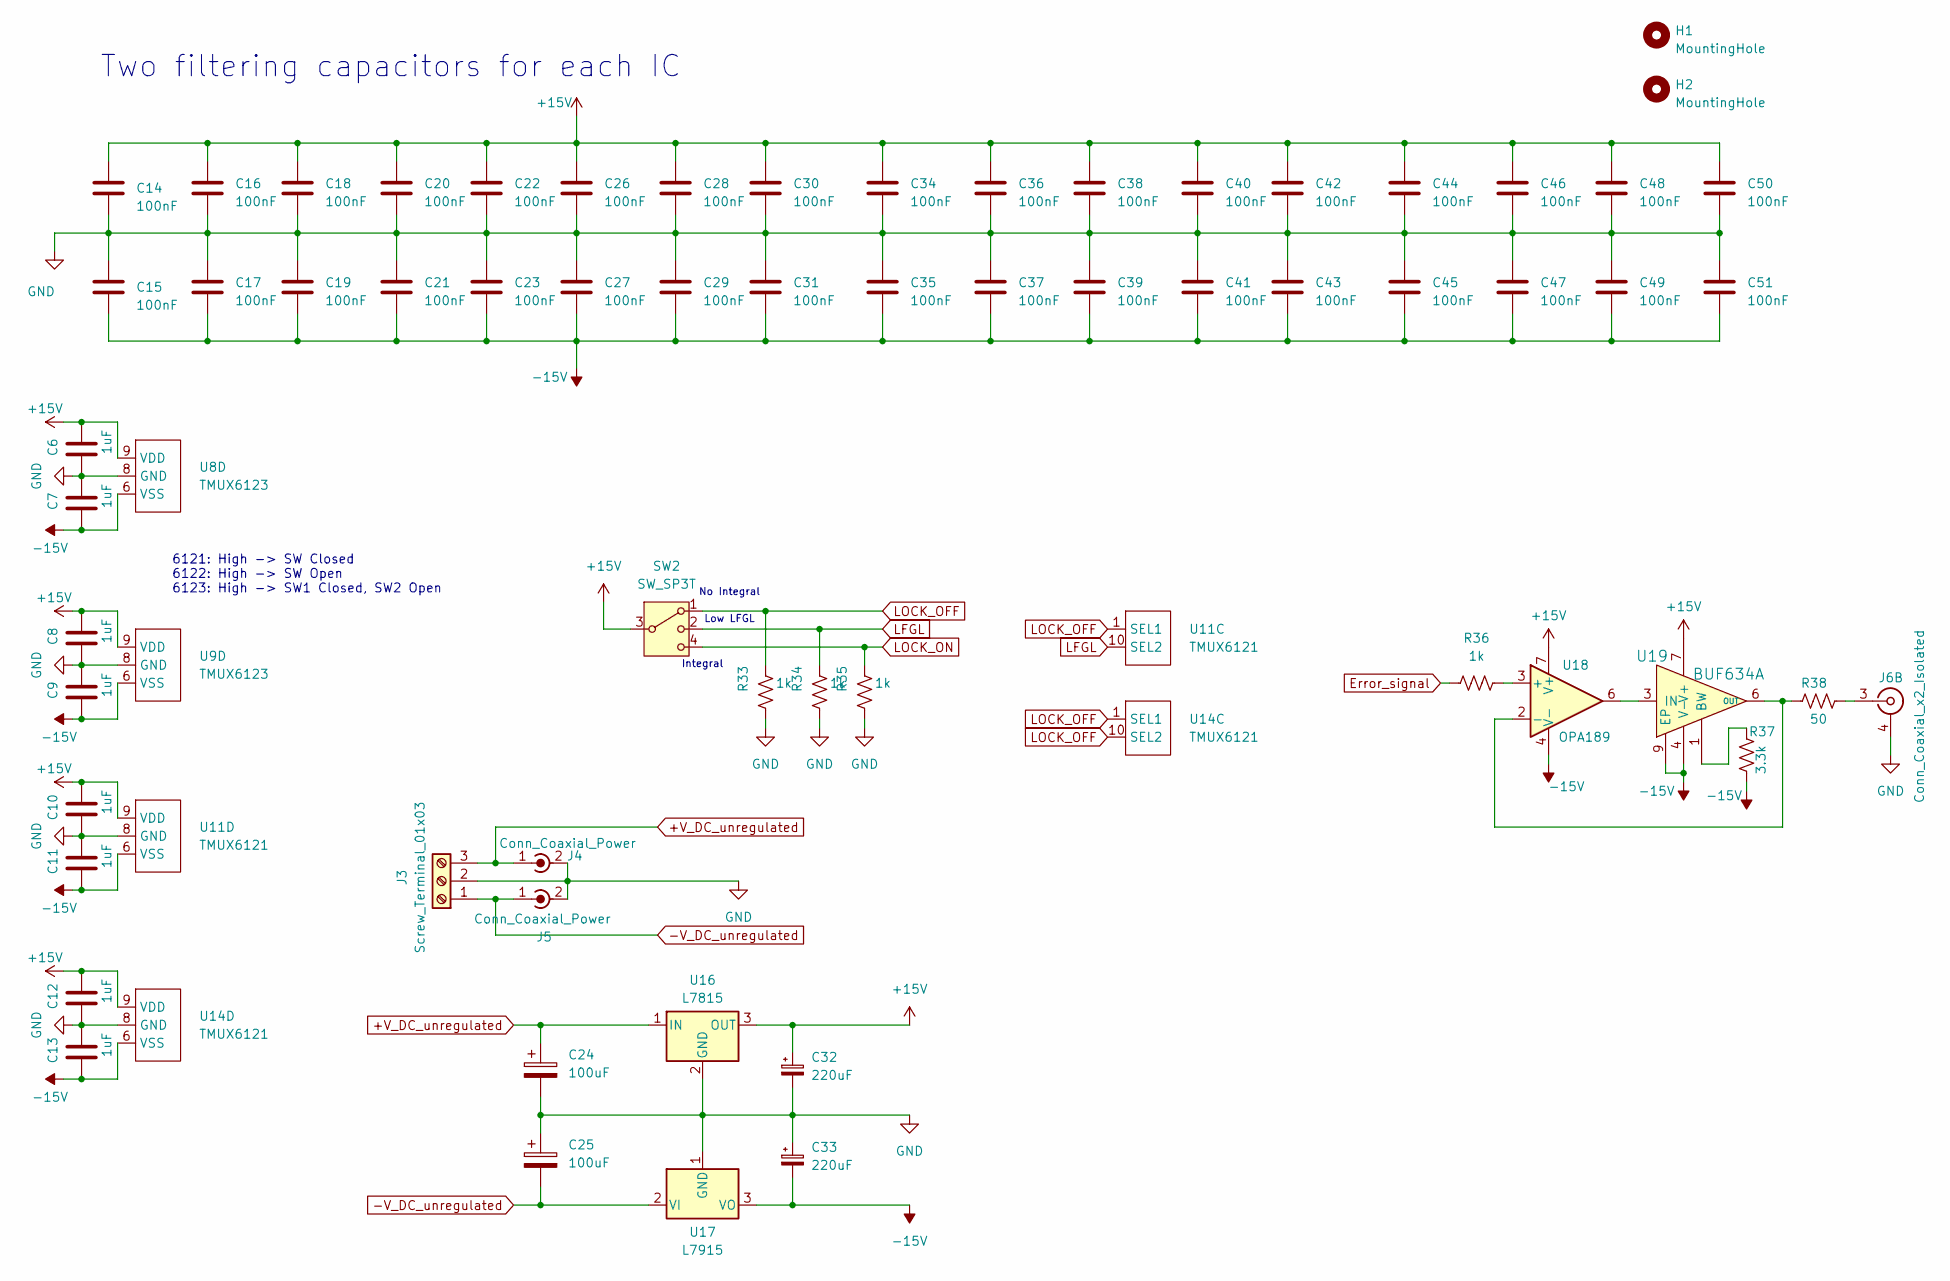
[picture p10: schematic supply.kicad_sch]

Parts:
C6, C7, C8, C9, C10, C11, C12, C13: 1uF; C_0805_2012Metric; PARTNO CL21B105KAFNNNG; DIGIKEY 1276-6469-1-ND
C14, C15, C16, C17, C18, C19, C20, C21, C22, C23, C26, C27, C28, C29, C30, C31, C34, C35, C36, C37, C38, C39, C40, C41, C42, C43, C44, C45, C46, C47, C48, C49, C50, C51: 100nF; C_0805_2012Metric; PARTNO CL21B104KCFNNNE; DIGIKEY 1276-6840-1-ND
C24, C25: 100uF; CP_Elec_8x6.5; PARTNO 35PJV100M6.3X8; DIGIKEY 1189-35PJV100M6.3X8CT-ND
C32, C33: 220uF; CP_Elec_10x10.5; PARTNO EEE-FK1H221P; DIGIKEY PCE3812CT-ND
H1, H2: MountingHole; MountingHole_3.2mm_M3_ISO14580
J3: Screw_Terminal_01x03; TerminalBlock_4Ucon_1x03_P3.50mm_Horizontal; PARTNO 691214110003; DIGIKEY 732-2748-ND
J4, J5: Conn_Coaxial_Power; SMA_Amphenol_901-143_Horizontal
J6: Conn_Coaxial_x2_Isolated; BNC_Amphenol_031-6575_Horizontal; PARTNO 031-6575; DIGIKEY ARF2111-ND
R33, R34, R35, R36: 1k; R_0805_2012Metric; PARTNO RG2012P-102-B-T5; DIGIKEY RG20P1.0KBCT-ND
R37: 3.3k; R_0805_2012Metric; PARTNO RC0805FR-073K3L; DIGIKEY 311-3.30KCRCT-ND
R38: 50; R_0805_2012Metric; PARTNO CRCW080550R0FKTA; DIGIKEY 541-CRCW080550R0FKTACT-ND
SW2: SW_SP3T; Right Angle SP3T Vertical; PARTNO 100DP6T1B4M7RE; DIGIKEY EG5746-ND
U8, U9: TMUX6123; PARTNO TMUX6123DGSR; DIGIKEY 296-53449-1-ND
U11, U14: TMUX6121; PARTNO TMUX6123DGSR; DIGIKEY 296-53449-1-ND
U16: L7815; TO-263-3_TabPin2; PARTNO MC7815BDTRKG; DIGIKEY MC7815BDTRKGOSCT-ND
U17: L7915; TO-263-3_TabPin2; PARTNO MC7915ACD2TG; DIGIKEY MC7915ACD2TGOS-ND
U18: OPA189; SOIC-8_3.9x4.9mm_P1.27mm; PARTNO OPA189ID; DIGIKEY 296-47522-ND
U19: BUF634A; BUF634AIDDAR; PARTNO BUF634AIDDAR; DIGIKEY 296-BUF634AIDDARCT-ND

Connections:
+15V: C6.1, C8.1, C10.1, C12.1, C14.1, C16.1, C18.1, C20.1, C22.1, C26.1, C28.1, C30.1, C32.1, C34.1, C36.1, C38.1, C40.1, C42.1, C44.1, C46.1, C48.1, C50.1, SW2.3, U8.9 (VDD), U9.9 (VDD), U11.9 (VDD), U14.9 (VDD), U16.3 (OUT), U18.7 (V+), U19.7 (V+); also elsewhere on the board
+V_DC_unregulated: C24.1, J3.3, J4.1 (In), U16.1 (IN)
-15V: C7.2, C9.2, C11.2, C13.2, C15.2, C17.2, C19.2, C21.2, C23.2, C27.2, C29.2, C31.2, C33.2, C35.2, C37.2, C39.2, C41.2, C43.2, C45.2, C47.2, C49.2, C51.2, R37.1, U8.6 (VSS), U9.6 (VSS), U11.6 (VSS), U14.6 (VSS), U17.3 (VO), U18.4 (V-), U19.4 (V-), U19.9 (EP); also elsewhere on the board
-V_DC_unregulated: C25.2, J3.1, J5.1 (In), U17.2 (VI)
Error_signal: R36.2; also elsewhere on the board
GND: C6.2, C7.1, C8.2, C9.1, C10.2, C11.1, C12.2, C13.1, C14.2, C15.1, C16.2, C17.1, C18.2, C19.1, C20.2, C21.1, C22.2, C23.1, C24.2, C25.1, C26.2, C27.1, C28.2, C29.1, C30.2, C31.1, C32.2, C33.1, C34.2, C35.1, C36.2, C37.1, C38.2, C39.1, C40.2, C41.1, C42.2, C43.1, C44.2, C45.1, C46.2, C47.1, C48.2, C49.1, C50.2, C51.1, J3.2, J4.2 (Ext), J5.2 (Ext), J6.4 (Ext2), R33.2, R34.2, R35.2, U8.8 (GND), U9.8 (GND), U11.8 (GND), U14.8 (GND), U16.2 (GND), U17.1 (GND); also elsewhere on the board
LFGL: R34.1, SW2.2, U11.10 (SEL2)
LOCK_OFF: R33.1, SW2.1, U11.1 (SEL1), U14.1 (SEL1), U14.10 (SEL2)
LOCK_ON: R35.1, SW2.4
unnamed: J6.3 (In2), R38.2
unnamed: R36.1, U18.3 (+)
unnamed: R38.1, U18.2 (-), U19.6 (OUT)
unnamed: R37.2, U19.1 (BW)
unnamed: U18.6, U19.3 (IN)

Notes on the sheet:
6121: High -> SW Closed 6122: High -> SW Open 6123: High -> SW1 Closed, SW2 Open
Two filtering capacitors for each IC
Integral
No Integral
Low LFGL

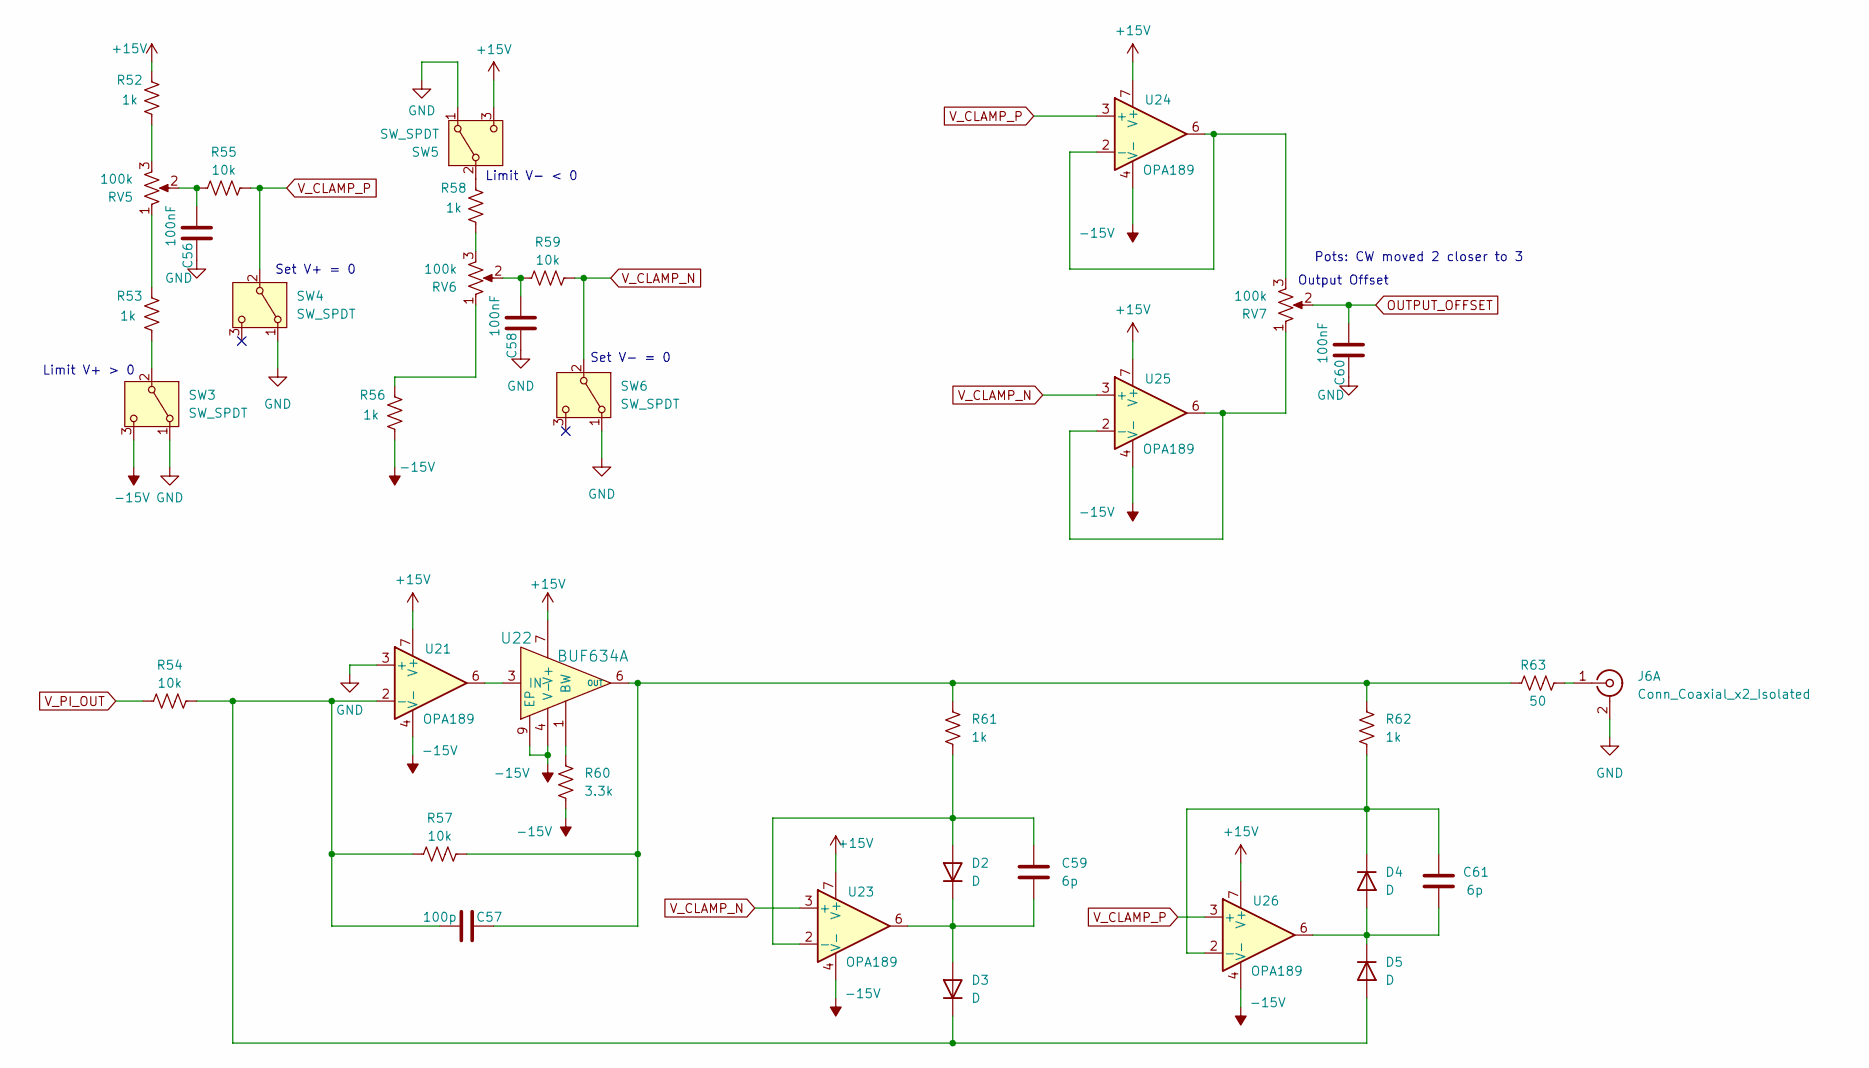
[picture p11: schematic output_clamping.kicad_sch]

Parts:
C56, C58, C60: 100nF; C_0805_2012Metric; PARTNO CL21B104KCFNNNE; DIGIKEY 1276-6840-1-ND
C57: 100p; C_0805_2012Metric; PARTNO C0805C101J5GACTU; DIGIKEY 399-C0805C101J5GACTUCT-ND
C59, C61: 6p; C_0805_2012Metric
D2, D3, D4, D5: D; TSOT-23; PARTNO SSTPAD5 SOT-23 3L ROHS; DIGIKEY 4004-SSTPAD5SOT-233LROHSCT-ND
J6: Conn_Coaxial_x2_Isolated; BNC_Amphenol_031-6575_Horizontal; PARTNO 031-6575; DIGIKEY ARF2111-ND
R52, R53, R56, R58: 1k; R_0805_2012Metric
R54, R55, R57, R59: 10k; R_0805_2012Metric; PARTNO RN73H2ATTD1002B25; DIGIKEY 2019-RN73H2ATTD1002B25CT-ND
R60: 3.3k; R_0805_2012Metric; PARTNO RC0805FR-073K3L; DIGIKEY 311-3.30KCRCT-ND
R61, R62: 1k; R_0805_2012Metric; PARTNO RG2012P-102-B-T5; DIGIKEY RG20P1.0KBCT-ND
R63: 50; R_0805_2012Metric; PARTNO CRCW080550R0FKTA; DIGIKEY 541-CRCW080550R0FKTACT-ND
RV5, RV6: 100k; Potentiometer_Bourns_3296W_Vertical; PARTNO PV36W104C01B00; DIGIKEY 118-PV36W104C01B00-ND
RV7: 100k; Bourns Circular Pots; PARTNO 3590P-2-104L; DIGIKEY 3590P-2-104L-ND
SW3, SW4, SW5, SW6: SW_SPDT; TDD DIP Switch; PARTNO TDD01H0SB1R; DIGIKEY CKN10546CT-ND
U21, U23, U24, U25, U26: OPA189; SOIC-8_3.9x4.9mm_P1.27mm; PARTNO OPA189ID; DIGIKEY 296-47522-ND
U22: BUF634A; BUF634AIDDAR; PARTNO BUF634AIDDAR; DIGIKEY 296-BUF634AIDDARCT-ND

Connections:
+15V: R52.2, SW5.3 (C), U21.7 (V+), U22.7 (V+), U23.7 (V+), U24.7 (V+), U25.7 (V+), U26.7 (V+); also elsewhere on the board
-15V: R56.1, R60.1, SW3.3 (C), U21.4 (V-), U22.4 (V-), U22.9 (EP), U23.4 (V-), U24.4 (V-), U25.4 (V-), U26.4 (V-); also elsewhere on the board
GND: C56.1, C58.1, C60.1, J6.2 (Ext1), SW3.1 (A), SW4.1 (A), SW5.1 (A), SW6.1 (A), U21.3 (+); also elsewhere on the board
unnamed: C56.2, R55.1, RV5.2
unnamed: C58.2, R59.1, RV6.2
unnamed: C59.1, D2.2 (A), R61.1, U23.2 (-)
unnamed: C59.2, D2.1 (K), D3.2 (A), U23.6
unnamed: C57.2, D3.1 (K), D5.2 (A), R54.2, R57.1, U21.2 (-)
unnamed: C61.2, D4.2 (A), D5.1 (K), U26.6
unnamed: C61.1, D4.1 (K), R62.1, U26.2 (-)
unnamed: J6.1 (In1), R63.2
unnamed: R52.1, RV5.3
unnamed: R53.2, RV5.1
unnamed: R56.2, RV6.1
unnamed: R58.1, RV6.3
unnamed: R53.1, SW3.2 (B)
unnamed: R58.2, SW5.2 (B)
unnamed: R60.2, U22.1 (BW)
unnamed: U21.6, U22.3 (IN)
unnamed: C57.1, R57.2, R61.2, R62.2, R63.1, U22.6 (OUT)
unnamed: RV7.3, U24.2 (-), U24.6
unnamed: RV7.1, U25.2 (-), U25.6
OUTPUT_OFFSET: C60.2, RV7.2; also elsewhere on the board
V_CLAMP_N: R59.2, SW6.2 (B), U23.3 (+), U25.3 (+); also elsewhere on the board
V_CLAMP_P: R55.2, SW4.2 (B), U24.3 (+), U26.3 (+); also elsewhere on the board
V_PI_OUT: R54.1; also elsewhere on the board

Notes on the sheet:
Limit V+ > 0
Set V- = 0
Set V+ = 0
Limit V- < 0
Output Offset
Pots: CW moved 2 closer to 3

Board: 4 copper layers, 185 parts (0 on the bottom side), 85 nets, no tracks yet.
