staneja1/PI_wt_hold_for_laser_intensity_lock/(commit log)

2025-06-30 Importing unfinished project files from archive
    [intensity_pi.kicad_pcb, intensity_pi.kicad_sch, supply.kicad_sch]
2025-06-30 Updated Schematic, removed sw1,2,3a,4, have to fix 3a for zero offset switch
    [intensity_pi.kicad_pcb, intensity_pi.kicad_sch, supply.kicad_sch]
2025-07-02 Finished Cleaning up Schematic, TODO: Add LED and pick parts
    [intensity_pi.kicad_pcb, intensity_pi.kicad_sch, supply.kicad_sch]
2025-07-02 Cleaned up PCB, custom footprint for switch
    [intensity_pi.kicad_pcb, intensity_pi.kicad_sch, supply.kicad_sch]
2025-07-03 Added all features to schematic, TODO: fix pot footprint and layout pcb
    [intensity_pi.kicad_pcb, intensity_pi.kicad_sch, led_threshold.kicad_sch, supply.kicad_sch]
2025-07-04 Finished Schematic and Assigning Footprint pending Review, TODO: Layout Board
    [intensity_pi.kicad_pcb, intensity_pi.kicad_sch, led_threshold.kicad_sch]
2025-07-04 First portion of routing
    [intensity_pi.kicad_pcb, supply.kicad_sch]
2025-07-07 Updates to PCB placement, removed one extra capacitor pair
    [intensity_pi.kicad_pcb, intensity_pi.kicad_sch, led_threshold.kicad_sch, supply.kicad_sch]
2025-07-07 Fixed Error Threshold Control, replaced 2x optocouplers with transistors, added power rectification + regulators for 15VAC to +- 15VDC, finished pcb routing, TODO: Check all components have parts, ch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
    [intensity_pi.kicad_pcb, intensity_pi.kicad_sch, led_threshold.kicad_sch, supply.kicad_sch]
2025-07-08 Fixed LED Threshold schematic, added second power input screw terminal, first attempt at final placement and routing
    [intensity_pi.kicad_pcb, intensity_pi.kicad_sch, led_threshold.kicad_sch, supply.kicad_sch]
2025-07-09 Removed large cap and rectifier, added transistor resistors
    [intensity_pi.kicad_pcb, led_threshold.kicad_sch, supply.kicad_sch]
2025-07-11 Final Schematic, Reworking PCB pt 1
    [intensity_pi.kicad_pcb, intensity_pi.kicad_sch, supply.kicad_sch]
2025-07-14 Condensed Layout, Removed 5V supply, Shortened Board
    [intensity_pi.kicad_pcb, intensity_pi.kicad_sch, led_threshold.kicad_sch, supply.kicad_sch]
2025-07-14 Further improvements to layout, reduce potential for crosstalk
    [intensity_pi.kicad_pcb]
2025-07-15 Rearranged Edge Componenets, simpler board, wider but shorter depth
    [intensity_pi.kicad_pcb, intensity_pi.kicad_sch, led_threshold.kicad_sch]
2025-07-15 Further Layout Refinements
    [intensity_pi.kicad_pcb]
2025-07-17 Added 1k resistor to monitor, TODO: check BOM, reorg PI+LFGL, check power planes/return path, move A,B closer to PI, compress vertically
    [intensity_pi.kicad_pcb, intensity_pi.kicad_sch, led_threshold.kicad_sch]
2025-07-18 Updated Design, more compact layout, precise location values for I/O, Fixed TrimPot footprint, TODO: Finalize BOM, add partnos for SMD R/Cs
    [intensity_pi.kicad_pcb, led_threshold.kicad_sch, supply.kicad_sch]
2025-07-18 Minor Layout updates, replaced old component part no's, added part no's for rest of parts
    [intensity_pi.kicad_pcb, intensity_pi.kicad_sch, led_threshold.kicad_sch, supply.kicad_sch]
2025-07-20 Minor Updates to layout, TODO: Redo PI layout
    [intensity_pi.kicad_pcb]
2025-07-20 Reworked PI control layout, minimize feedback loop size
    [intensity_pi.kicad_pcb]
2025-07-21 Updated PI control Layout, fixed circular pot footprint so that CW rotation decreases R
    [intensity_pi.kicad_pcb]
2025-07-22 Revert change to Library Footprint for switch, update schematic to use resistance between pins 2,3 as starting at maximum, decreasing down on CW rotation
    [intensity_pi.kicad_pcb, intensity_pi.kicad_sch]
2025-07-23 Connected other leg of Pots, added 3d models from manufacturer for switch+pots
    [100SPxT2B4M7xE.stp, 141_100SPxT2B4M6xE.stp, 3590p-2.stp, intensity_pi.kicad_pcb, intensity_pi.kicad_sch, led_threshold.kicad_sch]
2025-07-24 Fixed Digikey Part numbers for some parts, confirmed final BOM, Fixed Switch Footprint hole size
    [intensity_pi.kicad_pcb, intensity_pi.kicad_sch, intensity_pi_BOM.csv, led_threshold.kicad_sch, supply.kicad_sch]
2025-07-24 Small Routing Changes, Fix Silkscreen part references
    [intensity_pi.kicad_pcb]
2025-07-24 Minor routing improvements
    [intensity_pi.kicad_pcb]
2025-07-26 Removal of antennas and other changes
    The following edits has been made:
    1) Simplification of certain critical traces
    2) Removal of all antennas. Antennas are large traces connected to high
    impedance nodes. I'm quite strict about what high impedance means.
    Anything larger than a few Ohm can be considered high impedance.
    3) Added labels most silkscreen labels where outside the physical board
    area
    4) Added a thermal area to force
    TO DO:
    1) Add explanation near to all switches and trimpots
    2) Check DRC
    3) Add some GND vias
    4) Check very carefully gerbers to see if any obvious manifacturing
    issue emerges
    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
    [intensity_pi.kicad_pcb, intensity_pi.kicad_sch, led_threshold.kicad_sch, supply.kicad_sch]
2025-07-28 fixing missing traces and adding additional vias
    [intensity_pi.kicad_pcb]
2025-10-14 V1.1, Fixedincorrect footprints for Green/Red LED, Diodes, Mosfets, Flipped Input A/B Polarity, Potentiometer labels, Incorrect part nos for V regulators. No functionality changes
    [intensity_pi.kicad_pcb, intensity_pi.kicad_sch, intensity_pi_BOM.csv, led_threshold.kicad_sch, supply.kicad_sch]
2025-10-20 First pass at schematic for updated bidirectional clamping and output offset when the lock is turned off, no layout changes yet
    [intensity_pi.kicad_sch, led_threshold.kicad_sch, output_clamping.kicad_sch, supply.kicad_sch]
2025-10-20 Remove ground in between P and N clamps, as they can be the same sign
    [output_clamping.kicad_sch]
2026-05-31 Updated schematic and design
    [intensity_pi.kicad_pcb, intensity_pi.kicad_sch, led_threshold.kicad_sch, output_clamping.kicad_sch, supply.kicad_sch]
2026-06-02 First pass at updated schematic and loose PCB grouping, TODO: Fix PI Gain values
    [intensity_pi.kicad_pcb, intensity_pi.kicad_sch, led_threshold.kicad_sch, output_clamping.kicad_sch, supply.kicad_sch]
2026-06-30 Added Test Board to test various gain control as well as clamping mechanism
    [Test_VCA.kicad_sch, intensity_pi.kicad_pcb, intensity_pi.kicad_sch, output_clamping.kicad_sch, test_board.kicad_sch]
2026-08-06 Separated Test and Full Board Designs
    [100SPxT2B4M7xE.stp, 141_100SPxT2B4M6xE.stp, 3590p-2.stp, Test Board.kicad_pcb, Test Board.kicad_sch, Test_VCA.kicad_sch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]
2026-08-07 Removed LH circuit, added anti-windup test circuit, simplified voltage control mechanism
    [Test Board.kicad_pcb, Test Board.kicad_sch, Test_VCA.kicad_sch, new_clamp_anti_windup.kicad_sch]
2026-08-11 First pass at routing Test Board, TODO: Find and Double check Part numbers
    [Test Board.kicad_pcb, Test Board.kicad_sch, Test_VCA.kicad_sch, new_clamp_anti_windup.kicad_sch]
